dkorobkov/sync_from_gps/top.JPG

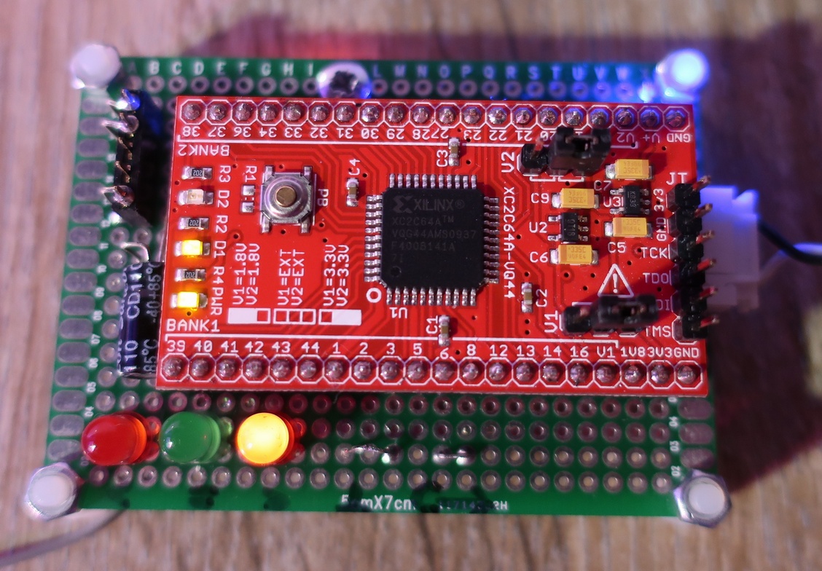
top.JPG
