dkorobkov/sync_from_gps/bottom.JPG

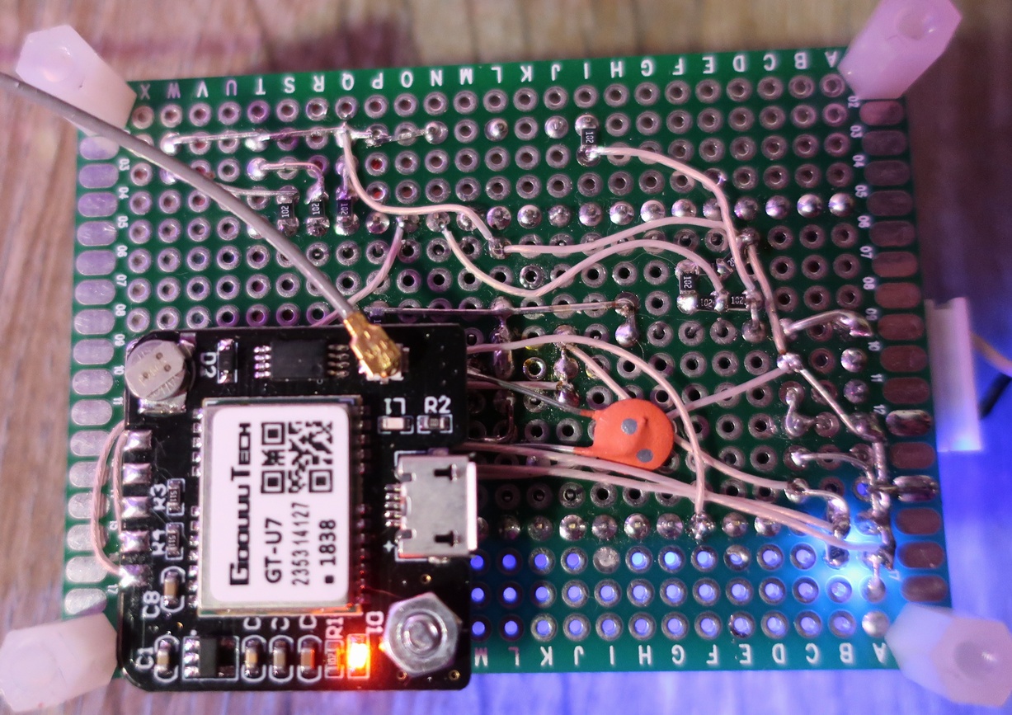
bottom.JPG
