dkorobkov/sync_from_gps/clock_from_gps.pdf

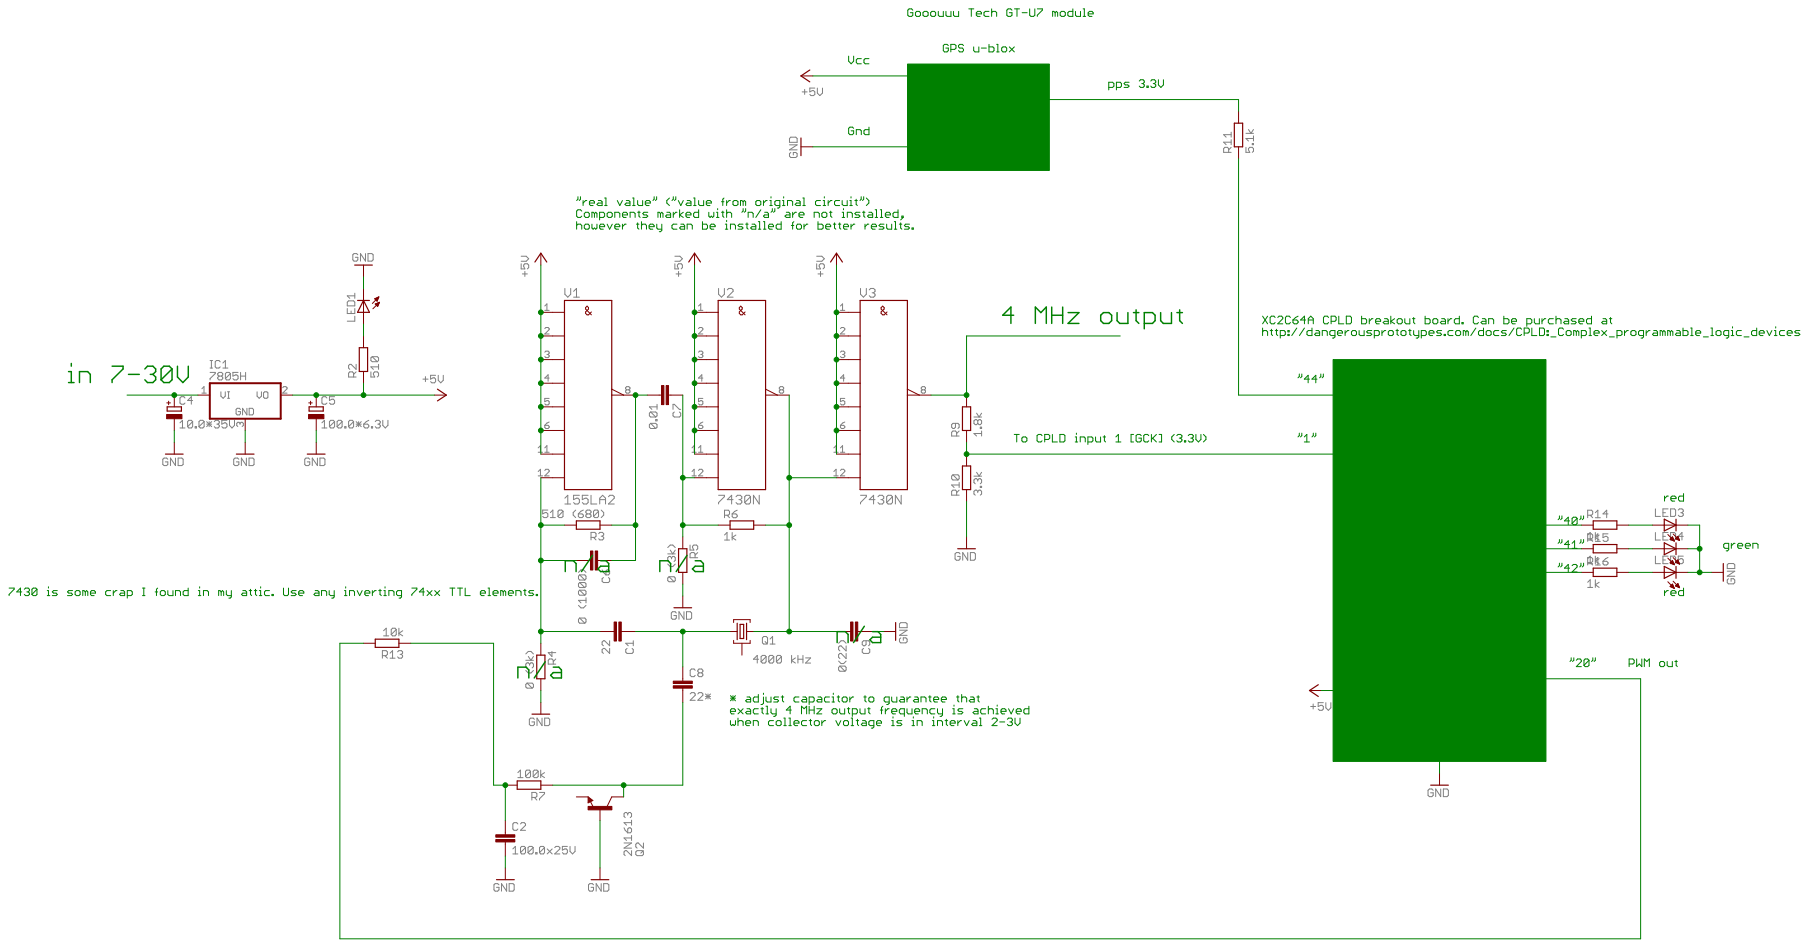
[picture p9: page 1]
