dkorobkov/sync_from_gps/clock_from_gps.sch

## EAGLE design clock_from_gps.sch (2019-12-02)

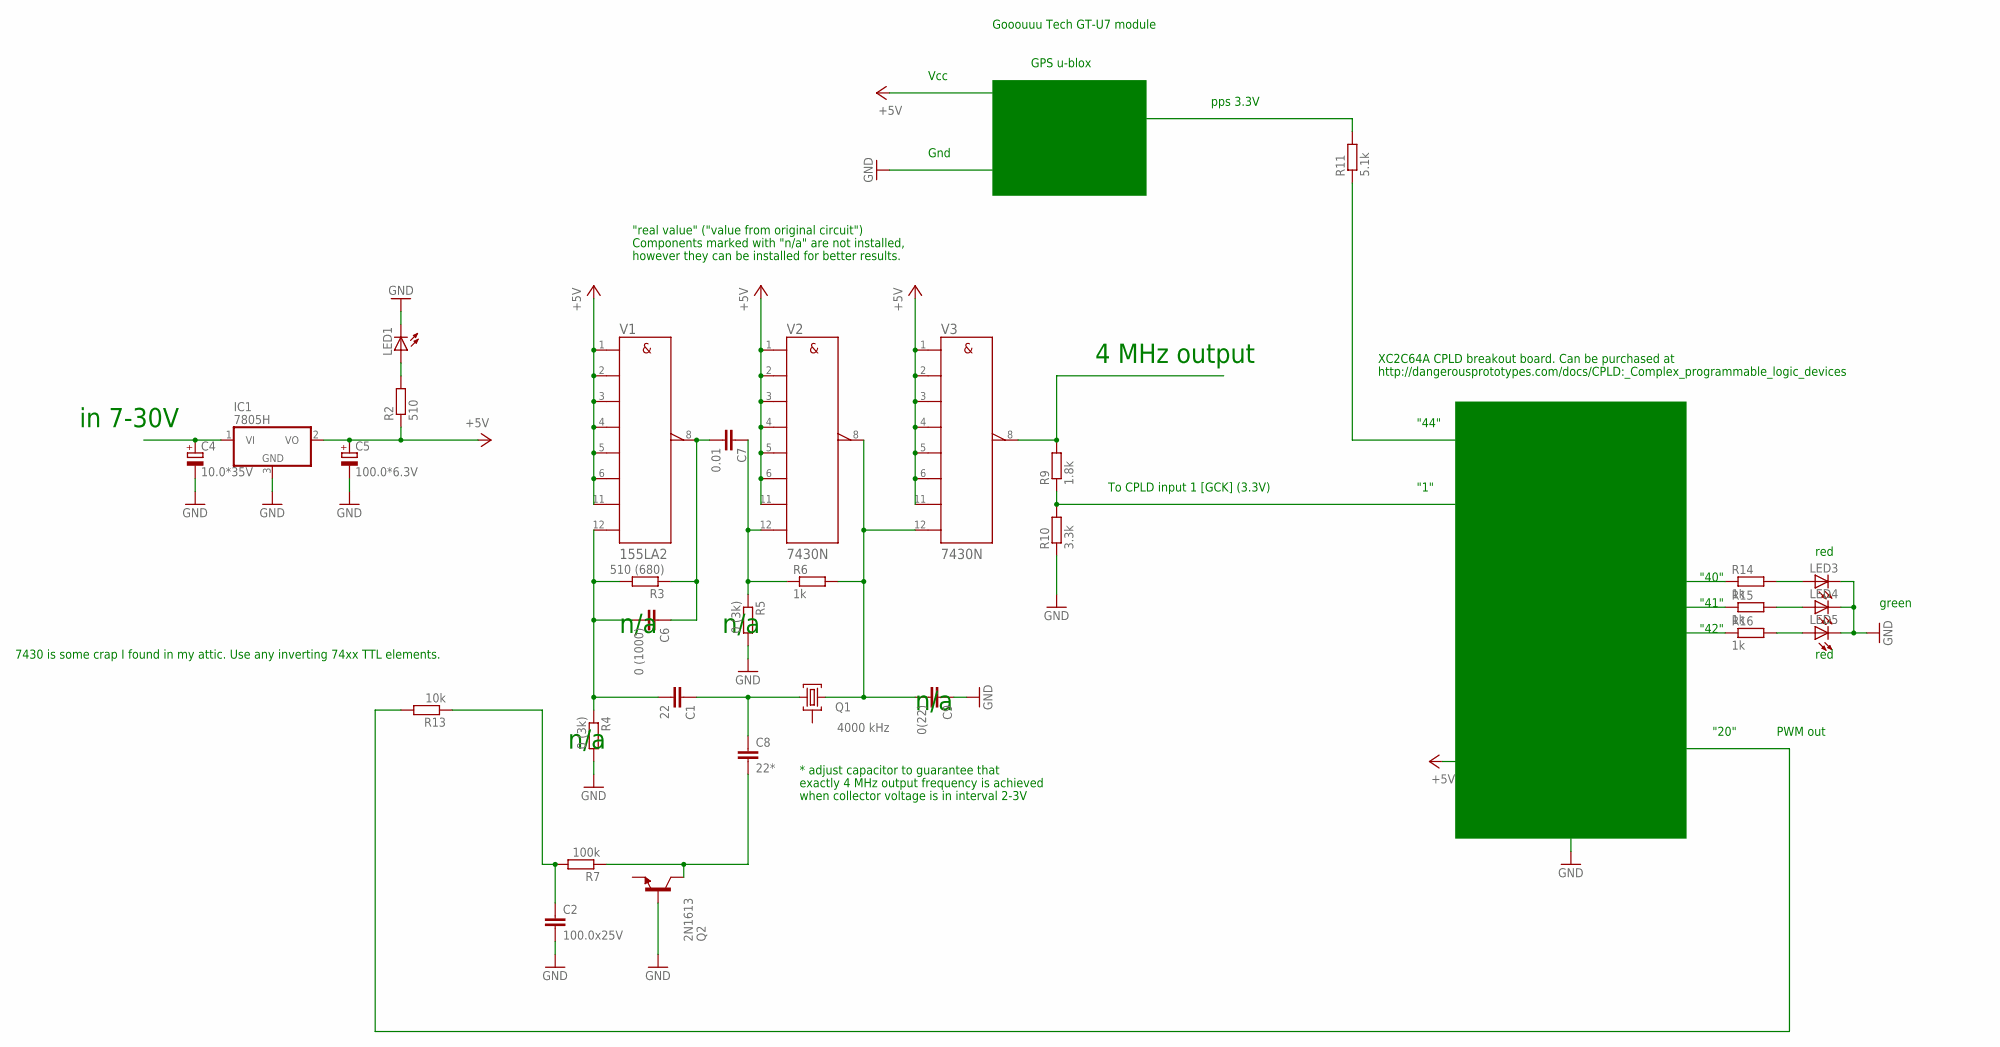
[picture p10: schematic clock_from_gps.sch]

Parts:
C1: 22; C025-024X044
C2: 100.0x25V; C025-024X044
C4: 10.0*35V; E5-4
C5: 100.0*6.3V; E5-4
C6: 0 (1000); C025-024X044
C7: 0.01; C025-024X044
C8: 22*; C025-024X044
C9: 0(22); C025-024X044
IC1: 7805H; TO39
LED1: LED3MM
LED3, LED4, LED5: LED; SMARTLED-TTW
Q1: 4000 kHz; HC49GW
Q2: 2N1613; TO5
R2: 510; 0204/5
R3: 510 (680); 0204/5
R4, R5: 0 (3k); 0204/5
R6, R14, R15, R16: 1k; 0204/5
R7: 100k; 0204/5
R9: 1.8k; 0204/5
R10: 3.3k; 0204/5
R11: 5.1k; 0204/5
R13: 10k; 0204/5
V1: 155LA2; DIL14
V2, V3: 7430N; DIL14

Connections:
+5V: C5.+, IC1.2 (VO), R2.1, V1.1 (A), V1.2 (B), V1.3 (C), V1.4 (D), V1.5 (E), V1.6 (F), V1.11 (G), V2.1 (A), V2.2 (B), V2.3 (C), V2.4 (D), V2.5 (E), V2.6 (F), V2.11 (G), V3.1 (A), V3.2 (B), V3.3 (C), V3.4 (D), V3.5 (E), V3.6 (F), V3.11 (G)
GND: C2.2, C4.-, C5.-, C9.1, IC1.3 (GND), LED1.K (C), LED3.C@1 (C), LED4.C@1 (C), LED5.C@1 (C), Q2.2 (B), R4.2, R5.2, R10.1
unnamed: C1.1, C8.1, Q1.2
unnamed: C2.1, R7.2, R13.1
unnamed: C1.2, C6.2, R3.2, R4.1, V1.12 (H)
unnamed: C6.1, C7.2, R3.1, V1.8 (Y)
unnamed: C7.1, R5.1, R6.1, V2.12 (H)
unnamed: C9.2, Q1.1, R6.2, V2.8 (Y), V3.12 (H)
unnamed: R9.2, V3.8 (Y)
unnamed: C8.2, Q2.3 (C), R7.1
unnamed: C4.+, IC1.1 (VI)
unnamed: LED1.A, R2.2
unnamed: R9.1, R10.2
unnamed: LED3.A@1 (A), R14.2
unnamed: LED4.A@1 (A), R15.2
unnamed: LED5.A@1 (A), R16.2

Notes on the sheet:
"real value" ("value from original circuit")
* adjust capacitor to guarantee that
when collector voltage is in interval 2-3V
exactly 4 MHz output frequency is achieved
To CPLD input 1 [GCK] (3.3V)
GPS u-blox
pps 3.3V
Vcc
Gnd
"44"
"1"
"20"
"40"
"41"
"42"
Gooouuu Tech GT-U7 module
http://dangerousprototypes.com/docs/CPLD:_Complex_programmable_logic_devices
7430 is some crap I found in my attic. Use any inverting 74xx TTL elements.
red
green
PWM out
4 MHz output
in 7-30V
n/a
Components marked with "n/a" are not installed,
however they can be installed for better results.
XC2C64A CPLD breakout board. Can be purchased at
