dkorobkov/sync_from_gps/(commit log)

2019-12-02 Schematic of clock generator synchronized from GPS PPS
    [clock_from_gps.sch]
2019-12-02 Add files via upload
    Schematic of clock generator synchronized from GPS PPS (PDF)
2019-12-02 Add files via upload
    Pictures of assembled board
